LafayetteFormulaElectricVehicle/JGB/(threads)

Thread 1 (2017-01-27):

CAN Bus through connection

Gregf36665, 2017-01-27:
Remove the 120 ohm resistor and replace it with a through connection

Thread 2 (2017-01-28):

Connectors

Gregf36665, 2017-01-28:
The screw terminals on the board are irritating and it would be nice to replace them with a socket.  Figure out what the CAN bus needs, perhaps it alone should stay as a screw terminal

Thread 3 (2017-01-28):

Replace LDO

Gregf36665, 2017-01-28:
The LDO is rated to 20V.  The power supply is upgrading to 24V.  Replace the LDO with a DC/DC converter that is rated high enough to provide enough current

Thread 4 (2017-01-28):

LED colors

Gregf36665, 2017-01-28:
The LEDs are not all the correct color.  The power LED should be green.  The TX and RX LEDs should be yellow.  Check the relay LED colors

Gregf36665, 2017-01-31:
Replaced power LED in schematic with Green LED

Thread 5 (2017-01-31):

Replace AMP1+/- with ADC

Gregf36665, 2017-01-31:
I can see more uses for ADC connectors than the AMP1+/-.  If someone wants to use the AMP there is 1 still around.  This would allow for 6 ADC inputs.  @LafayetteFormulaElectricVehicle/tsi This might make your life easier.
