LafayetteFormulaElectricVehicle/JGB/hardware/ATMEGA16M1.kicad_pcb

## KiCad design hardware/ATMEGA16M1.kicad_pcb (2017-01-27)

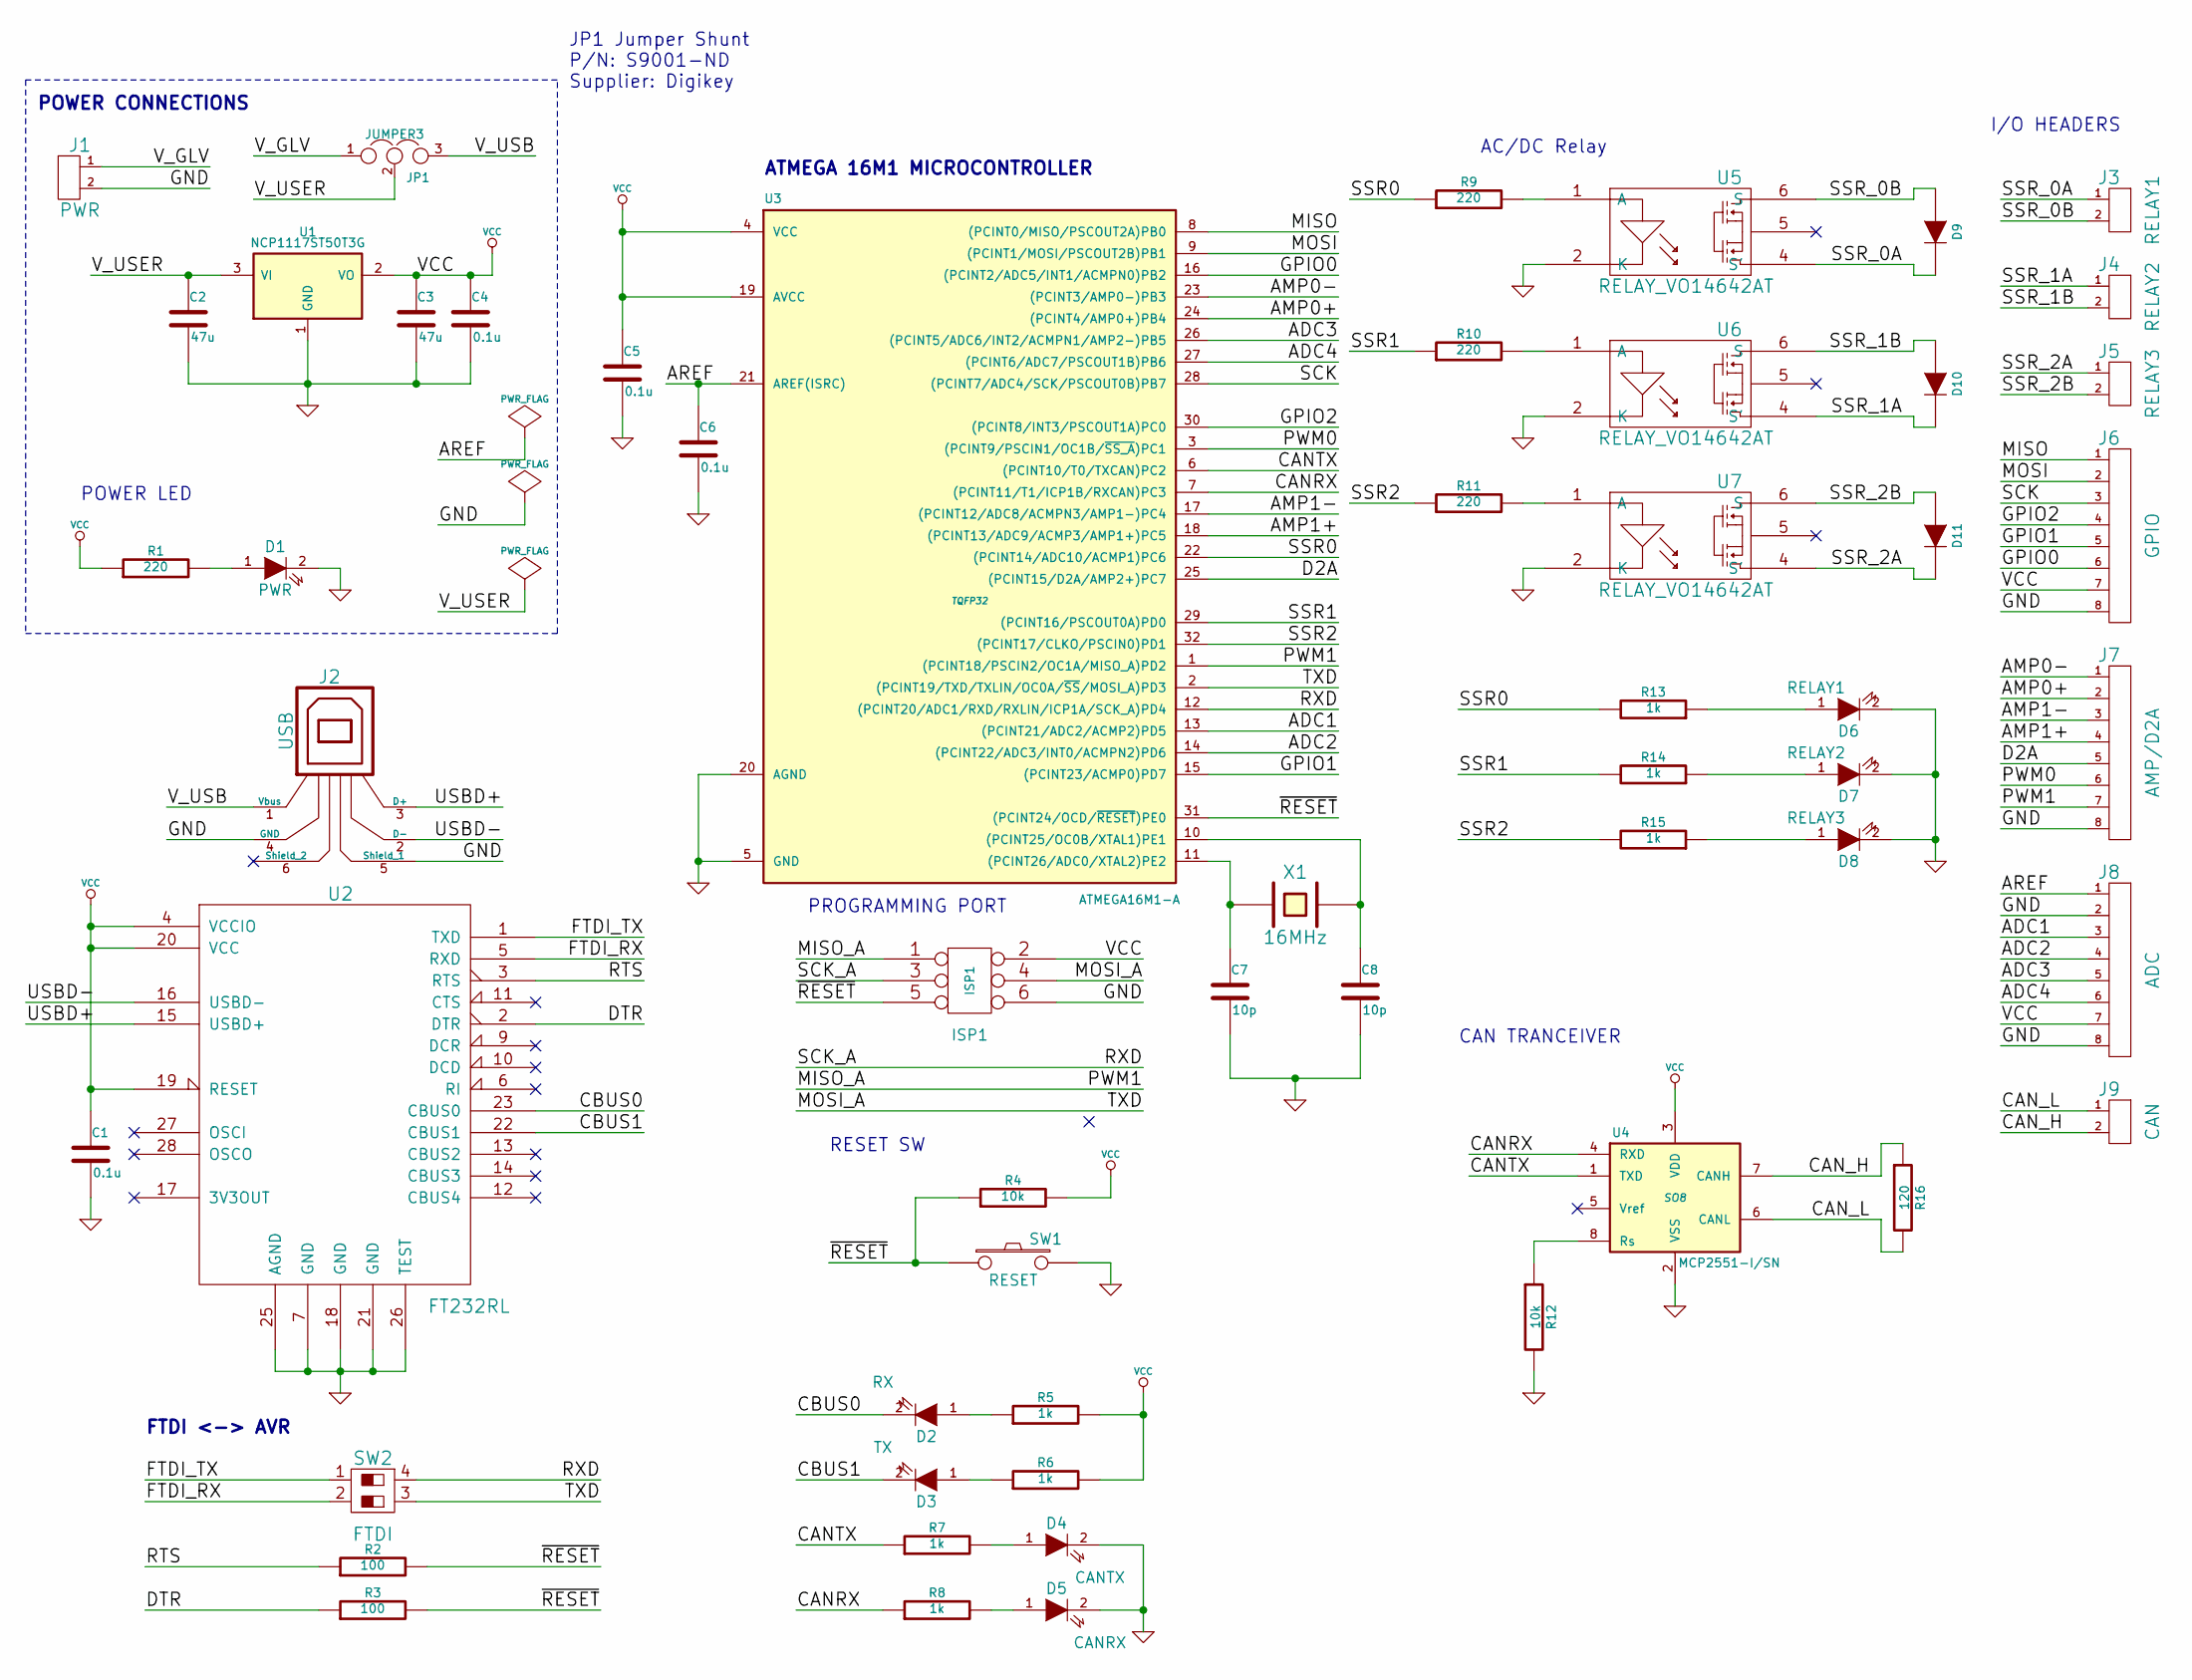
[picture p1: schematic ATMEGA16M1.sch, LFEF CAN Communication Board]

Parts:
C1, C4, C5, C6: 0.1u
C2, C3: 47u
C7, C8: 10p
D1: PWR
D2: RX
D3: TX
D4: CANTX
D5: CANRX
D6: RELAY1
D7: RELAY2
D8: RELAY3
D9, D10, D11: DIODE
ISP1: ISP1
J1: PWR
J2: USB
J3: RELAY1
J4: RELAY2
J5: RELAY3
J6: GPIO
J7: AMP/D2A
J8: ADC
J9: CAN
JP1: JUMPER3
R1, R9, R10, R11: 220
R2, R3: 100
R4, R12: 10k
R5, R6, R7, R8, R13, R14, R15: 1k
R16: 120
SW1: RESET
SW2: FTDI
U1: NCP1117ST50T3G
U2: FT232RL
U3: ATMEGA16M1-A; TQFP32
U4: MCP2551-I/SN; SO8
U5, U6, U7: RELAY_VO14642AT
X1: 16MHz

Connections:
/ADC1: J8.3, U3.13 ((PCINT21/ADC2/ACMP2)PD5)
/ADC2: J8.4, U3.14 ((PCINT22/ADC3/INT0/ACMPN2)PD6)
/ADC3: J8.5, U3.26 ((PCINT5/ADC6/INT2/ACMPN1/AMP2-)PB5)
/ADC4: J8.6, U3.27 ((PCINT6/ADC7/PSCOUT1B)PB6)
/AMP0+: J7.2, U3.24 ((PCINT4/AMP0+)PB4)
/AMP0-: J7.1, U3.23 ((PCINT3/AMP0-)PB3)
/AMP1+: J7.4, U3.18 ((PCINT13/ADC9/ACMP3/AMP1+)PC5)
/AMP1-: J7.3, U3.17 ((PCINT12/ADC8/ACMPN3/AMP1-)PC4)
/AREF: C6.1, J8.1, U3.21 (AREF(ISRC))
/CANRX: R8.1, U3.7 ((PCINT11/T1/ICP1B/RXCAN)PC3), U4.4 (RXD)
/CANTX: R7.1, U3.6 ((PCINT10/T0/TXCAN)PC2), U4.1 (TXD)
/CAN_H: J9.2, R16.1, U4.7 (CANH)
/CAN_L: J9.1, R16.2, U4.6 (CANL)
/CBUS0: D2.2 (K), U2.23 (CBUS0)
/CBUS1: D3.2 (K), U2.22 (CBUS1)
/D2A: J7.5, U3.25 ((PCINT15/D2A/AMP2+)PC7)
/DTR: R3.1, U2.2 (DTR)
/FTDI_RX: SW2.2, U2.5 (RXD)
/FTDI_TX: SW2.1, U2.1 (TXD)
/GPIO0: J6.6, U3.16 ((PCINT2/ADC5/INT1/ACMPN0)PB2)
/GPIO1: J6.5, U3.15 ((PCINT23/ACMP0)PD7)
/GPIO2: J6.4, U3.30 ((PCINT8/INT3/PSCOUT1A)PC0)
/MISO: J6.1, U3.8 ((PCINT0/MISO/PSCOUT2A)PB0)
/MISO_A: ISP1.1, J7.7, U3.1 ((PCINT18/PSCIN2/OC1A/MISO_A)PD2)
/MOSI: J6.2, U3.9 ((PCINT1/MOSI/PSCOUT2B)PB1)
/MOSI_A: ISP1.4, SW2.3, U3.2 ((PCINT19/TXD/TXLIN/OC0A/~SS~/MOSI_A)PD3)
/PWM0: J7.6, U3.3 ((PCINT9/PSCIN1/OC1B/~SS_A~)PC1)
/RTS: R2.1, U2.3 (RTS)
/RXD: ISP1.3, SW2.4, U3.12 ((PCINT20/ADC1/RXD/RXLIN/ICP1A/SCK_A)PD4)
/SCK: J6.3, U3.28 ((PCINT7/ADC4/SCK/PSCOUT0B)PB7)
/SSR0: R9.1, R13.2, U3.22 ((PCINT14/ADC10/ACMP1)PC6)
/SSR1: R10.1, R14.2, U3.29 ((PCINT16/PSCOUT0A)PD0)
/SSR2: R11.1, R15.2, U3.32 ((PCINT17/CLKO/PSCIN0)PD1)
/SSR_0A: D9.2 (K), J3.1, U5.4 (S')
/SSR_0B: D9.1 (A), J3.2, U5.6 (S)
/SSR_1A: D10.2 (K), J4.1, U6.4 (S')
/SSR_1B: D10.1 (A), J4.2, U6.6 (S)
/SSR_2A: D11.2 (K), J5.1, U7.4 (S')
/SSR_2B: D11.1 (A), J5.2, U7.6 (S)
/USBD+: J2.3 (D+), U2.15 (USBD+)
/USBD-: J2.2 (D-), U2.16 (USBD-)
/V_GLV: J1.1, JP1.1
/V_USB: J2.1 (Vbus), JP1.3
/V_USER: C2.1, JP1.2, U1.3 (VI)
/~RESET: ISP1.5, R2.2, R3.2, R4.1, SW1.1, U3.31 ((PCINT24/OCD/~RESET~)PE0)
GND: C1.2, C2.2, C3.2, C4.2, C5.2, C6.2, C7.2, C8.2, D1.2 (K), D4.2 (K), D5.2 (K), D6.2 (K), D7.2 (K), D8.2 (K), ISP1.6, J1.2, J2.4 (GND), J2.5 (Shield_1), J6.8, J7.8, J8.2, J8.8, R12.2, SW1.2, U1.1 (GND), U2.7 (GND), U2.18 (GND), U2.21 (GND), U2.25 (AGND), U2.26 (TEST), U3.5 (GND), U3.20 (AGND), U4.2 (VSS), U5.2 (K), U6.2 (K), U7.2 (K)
unnamed: R12.1, U4.8 (Rs)
unnamed: D7.1 (A), R14.1
unnamed: D3.1 (A), R6.1
unnamed: R11.2, U7.1 (A)
unnamed: R9.2, U5.1 (A)
unnamed: R10.2, U6.1 (A)
unnamed: D6.1 (A), R13.1
unnamed: D8.1 (A), R15.1
unnamed: D1.1 (A), R1.2
unnamed: D2.1 (A), R5.1
unnamed: D4.1 (A), R7.2
unnamed: D5.1 (A), R8.2
unnamed: C7.1, U3.11 ((PCINT26/ADC0/XTAL2)PE2), X1.1
unnamed: C8.1, U3.10 ((PCINT25/OC0B/XTAL1)PE1), X1.2
VCC: C1.1, C3.1, C4.1, C5.1, ISP1.2, J6.7, J8.7, R1.1, R4.2, R5.2, R6.2, U1.2 (VO), U2.4 (VCCIO), U2.19 (RESET), U2.20 (VCC), U3.4 (VCC), U3.19 (AVCC), U4.3 (VDD)

Notes on the sheet:
POWER CONNECTIONS
FTDI <-> AVR
ATMEGA 16M1 MICROCONTROLLER
AC/DC Relay
RESET SW
PROGRAMMING PORT
CAN TRANCEIVER
I/O HEADERS
POWER LED
JP1 Jumper Shunt P/N: S9001-ND Supplier: Digikey

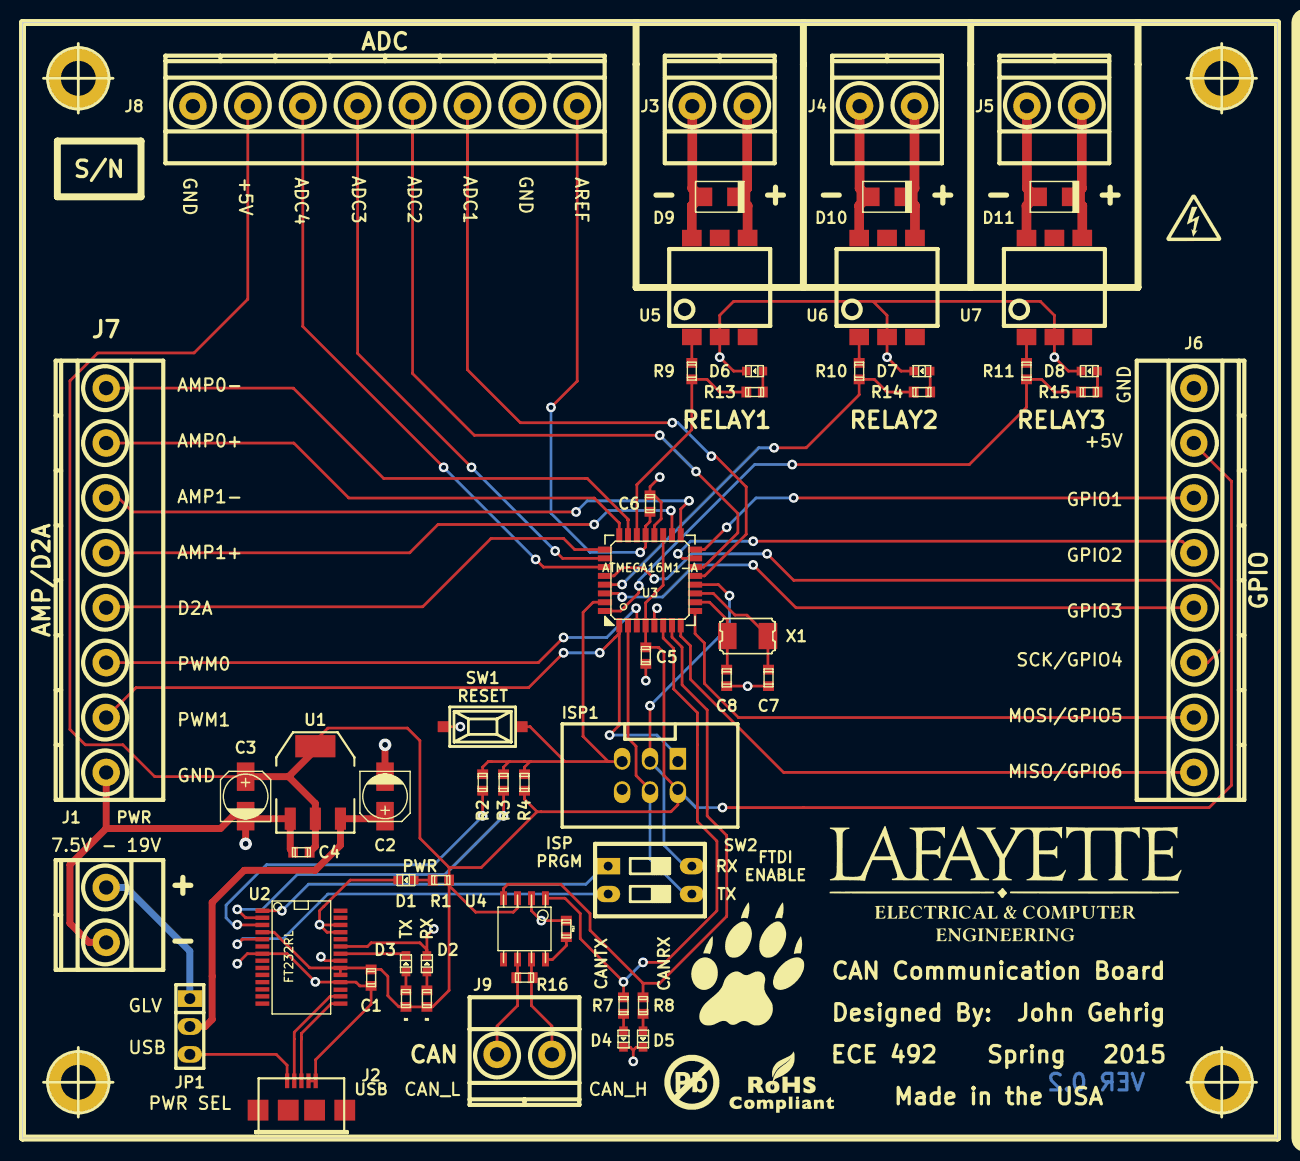
[picture p2: board ATMEGA16M1.kicad_pcb from above]

Board: 2 copper layers, 114.3 x 101.6 mm, 60 parts (0 on the bottom side), 61 nets.

Other parts of the board:
hole_5mm, hole_5mm#2, hole_5mm#3, hole_5mm#4: VAL**; hole_5mm
