LafayetteFormulaElectricVehicle/JGB/software/src/MyProject1/MyProject1/src/jgb.c

#include "jgb.h"

#include <avr/io.h>

#include <stdint.h>

void analog_setup(uint8_t mode, uint8_t scale) {
	switch(mode) {
		//AREF SETUP
		case ADC_AREF:
			ADCSRA = (scale << ADPS0);
			ADCSRB = (1 << AREFEN);
			ADCSRA = (1 << ADEN);
			break;
		//AVCC
		case ADC_AVCC:
			// AREF = AVcc
			ADMUX = (1<<REFS0);
			// ADC Enable and prescaler of 128
			// 16000000/128 = 125000
			ADCSRA = (1<<ADEN)|(1<<ADPS2)|(1<<ADPS1)|(1<<ADPS0);
			break;
	}
}

uint16_t adc_read(uint8_t pin) {
	//Clear Lower 5 bits (MUX[4:0])
	ADMUX &= ~(0x1F << MUX0);
	ADMUX |= (pin << MUX0);
	
	uint16_t adc_value;
	
	//throw out first conversion
	ADCSRA |= (1 << ADSC);
	while(ADCSRA & (1<<ADSC));
	adc_value = ADC;
	
	//2nd conversion gets saved
	ADCSRA |= (1 << ADSC);
	//Wait for complete conversion
	while(ADCSRA & (1<<ADSC));
	adc_value = ADC;
	
	return adc_value;
}

void dac_enable(void) {
	DACON = (1 << DAOE) | (1 << DAEN);
}

void dac_disable(void) {
	DACON = 0;
}

void dac_write(uint16_t level) {
	// The DACH write updates the d2a
	// DACH is only 2 bits wide
	// Max value 0x3FF
	DACL = level;
	DACH = (level >> 8);
}

void open_relay(uint8_t relay_num){
	
	if(relay_num == RELAY1){
		PORTC &= ~(1 << 6);
		}else if (relay_num == RELAY2){
		PORTD &= ~(1 << 0);
		}else if (relay_num == RELAY3){
		PORTD &= ~(1 << 1);
	}
	
}

void close_relay(uint8_t relay_num){
	
	if(relay_num == RELAY1){
		PORTC |= (1 << 6);
		}else if (relay_num == RELAY2){
		PORTD |= (1 << 0);
		}else if (relay_num == RELAY3){
		PORTD |= (1 << 1);
	}
	
}


void set_gpio_mode(uint8_t pin, uint8_t mode){
	if (mode){
		if(pin == GPIO0){
			DDRB |= (1 << 2);
			}else if (pin == GPIO1){
			DDRD |= (1 << 7);
			}else if (pin == GPIO2){
			DDRC |= (1 << 0);
		}
		}else{
		if(pin == GPIO0){
			DDRB &= ~(1 << 2); //sets the mode as input
			PORTB |= (1 << 2); //sets the pull up resistor active
			}else if (pin == GPIO1){
			DDRD &= ~(1 << 7);
			PORTD |= (1 << 7);
			}else if (pin == GPIO2){
			DDRC &= ~(1 << 0);
			PORTC |= (1 << 0);
		}
	}
	
}


void set_gpio(uint8_t pin){
	
	if(pin == GPIO0){
		PORTB |= (1 << 2);
		}else if (pin == GPIO1){
		PORTD |= (1 << 7);
		}else if (pin == GPIO2){
		PORTC |= (1 << 0);
	}
	
}

void clear_gpio(uint8_t pin){
	
	if(pin == GPIO0){
		PORTB &= ~(1 << 2);
		}else if (pin == GPIO1){
		PORTD &= ~(1 << 7);
		}else if (pin == GPIO2){
		PORTC &= ~(1 << 0);
	}
	
}

uint8_t read_gpio(uint8_t pin){
	
	if(pin == GPIO0){
		return ((0x04 & PINB) != 0);
		}else if (pin == GPIO1){
		return ((0x80 & PIND) != 0);
		}else if (pin == GPIO2){
		return ((0x01 & PINC) != 0);
	}
	return 0;
	
}
