LafayetteFormulaElectricVehicle/JGB/software/src/MyProject1/MyProject1/src/config.h

#ifndef CONFIG_H
#define CONFIG_H

//AVR CPU Speed (16MHz)
#define F_CPU 16000000
#define FOSC 16000

#define CAN_BAUDRATE 125
#define CAN_BUFFER_SIZE 8

//AVR RS-232 BAUD
#define BAUD 9600

//
#define BUFFER_SIZE 128

//
#define STRING_SIZE 128

#endif
