LafayetteFormulaElectricVehicle/JGB/software/RTOS_code/task_button.c

#include "task_button.h"


void task_button_init(void){
	DDRB &= ~(0x07);
	PORTB |= 0x07;
}

void task_button(uint32_t data){
	
	task_button_init();
	for(;;){
		if((PINB & 0x04) != 0x04){// button 0 is depressed (up)
			button_up = true;
			while((PINB & 0x04) != 0x04){//wait for button to not be depressed
				atomTimerDelay(5);
			}
			//while((PINB & 0x01) == 0x01){// wait 50 ms for switch bounce
				atomTimerDelay(5);
			//}
		
		}else if((PINB & 0x02) != 0x02){// button 1 is depressed (down)
			button_down = true;
			while((PINB & 0x02) != 0x02){//wait for button to not be depressed
				atomTimerDelay(5);
			}
			//while((PINB & 0x02) == 0x02){// wait 50 ms for switch bounce
				atomTimerDelay(5);
			//}
			
		}else if((PINB & 0x01) != 0x01){// button 2 is depressed (select)
			//not currently used
		
		}
		
		
	}
}
