LafayetteFormulaElectricVehicle/JGB/(commit log)

2017-01-27 Pushed up John's old work
    [ATMEGA16M1-B_Cu.gbl, ATMEGA16M1-B_Mask.gbs, ATMEGA16M1-B_SilkS.gbo, ATMEGA16M1-Edge_Cuts.gbr, ATMEGA16M1-F_Cu.gtl, ATMEGA16M1-F_Mask.gts, ATMEGA16M1-F_SilkS.gto, ATMEGA16M1.drl]
2017-01-28 Started to create jgb file. Documentating ADC and D2A functions
2017-01-29 added relay functionality
    [_saved_ATMEGA16M1.sch]
2017-01-29 added GPIO pull up resistor activation
2017-01-29 Merged ADC.h into JGB.h
2017-01-29 cleaned up some of the files to be error-free in avr design ide
    [can_frame.c, can_frame.h, jgb.h]
2017-02-02 added can_bust_test.c
    [_saved_ATMEGA16M1.sch]
2017-02-02 updated can_bus_test.c (isn't quite working yet) :(
2017-02-03 Updated schematic for JGB
    [ATMEGA16M1.sch]
2017-02-21 added can_test_board.c for jgb can test board
2017-04-07 Fixes to UART library.
    [main.c, uart.c]
2017-04-10 Changes to fix uart
    [main.c, uart.c]
2017-05-03 Changes towards PWm
